peiyu-xie/ucla-209-cache-bist/pcb/Group_12_v2.kicad_pcb

## KiCad design pcb/Group_12_v2.kicad_pcb (2026-10-20)

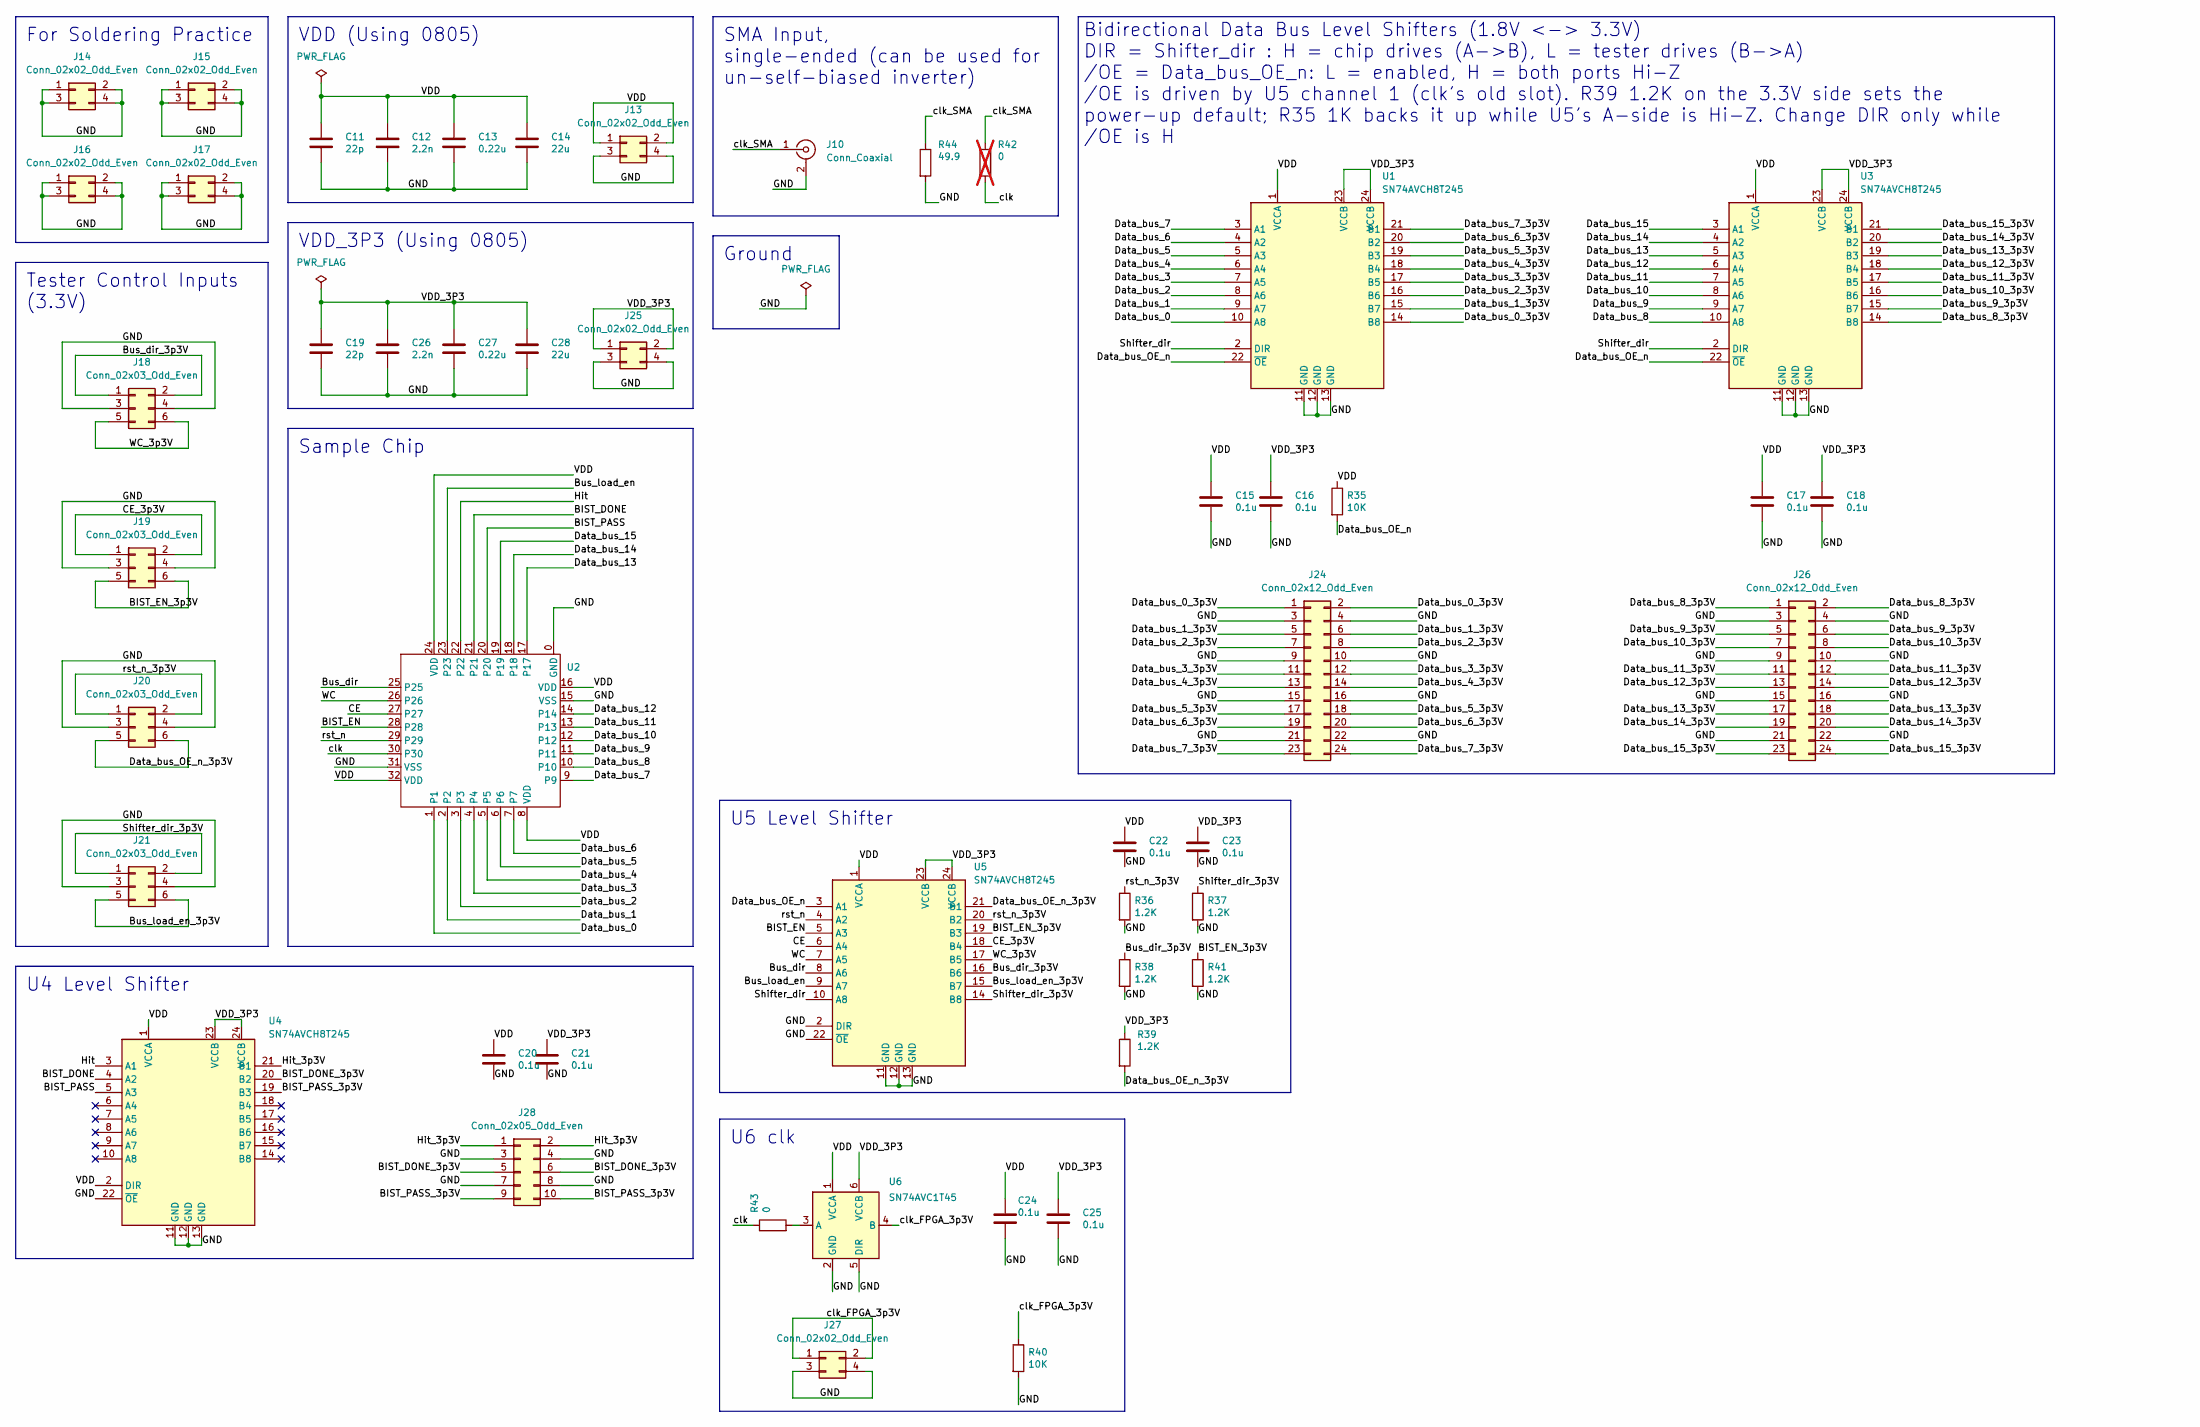
[picture p1: schematic Group_12_v2.kicad_sch]

Parts:
C11, C19: 22p; C_0805_2012Metric_Pad1.18x1.45mm_HandSolder; LCSC Part # C1804
C12, C26: 2.2n; C_0805_2012Metric_Pad1.18x1.45mm_HandSolder; LCSC Part # C28260
C13, C27: 0.22u; C_0805_2012Metric_Pad1.18x1.45mm_HandSolder; LCSC Part # C5378
C14, C28: 22u; C_0805_2012Metric_Pad1.18x1.45mm_HandSolder; LCSC Part # C45783
C15, C16, C17, C18, C20, C21, C22, C23, C24, C25: 0.1u; C_0805_2012Metric_Pad1.18x1.45mm_HandSolder; LCSC Part # C1711
J10: Conn_Coaxial; SMA_Samtec_SMA-J-P-H-ST-EM1_EdgeMount
J13, J14, J15, J16, J17, J25, J27: Conn_02x02_Odd_Even; PinHeader_2x02_P2.54mm_Vertical
J18, J19, J20, J21: Conn_02x03_Odd_Even; PinHeader_2x03_P2.54mm_Vertical
J24, J26: Conn_02x12_Odd_Even; PinHeader_2x12_P2.54mm_Vertical
J28: Conn_02x05_Odd_Even; PinHeader_2x05_P2.54mm_Vertical
R35, R40: 10K; R_0805_2012Metric_Pad1.20x1.40mm_HandSolder; LCSC Part # C17414
R36, R37, R38, R39, R41: 1.2K; R_0805_2012Metric_Pad1.20x1.40mm_HandSolder; LCSC Part # C17379
R42: 0; R_0805_2012Metric_Pad1.20x1.40mm_HandSolder; LCSC Part # C17477; not fitted
R43: 0; R_0805_2012Metric_Pad1.20x1.40mm_HandSolder; LCSC Part # C17477
R44: 49.9; R_0805_2012Metric_Pad1.20x1.40mm_HandSolder; LCSC Part # C17720
U1, U3, U4, U5: SN74AVCH8T245; TSSOP-24_4.4x7.8mm_P0.65mm; LCSC Part # C2652945
U2: EE209AS_2026
U6: SN74AVC1T45; SOT-23-6; LCSC Part # C131978

Connections:
/BIST_DONE: U2.21, U4.4 (A2)
/BIST_DONE_3p3V: J28.5, J28.6, U4.20 (B2)
/BIST_EN: U2.28, U5.5 (A3)
/BIST_EN_3p3V: J19.5, J19.6, R41.1, U5.19 (B3)
/BIST_PASS: U2.20, U4.5 (A3)
/BIST_PASS_3p3V: J28.9, J28.10, U4.19 (B3)
/Bus_dir: U2.25, U5.8 (A6)
/Bus_dir_3p3V: J18.1, J18.2, R38.1, U5.16 (B6)
/Bus_load_en: U2.23, U5.9 (A7)
/Bus_load_en_3p3V: J21.5, J21.6, U5.15 (B7)
/CE: U2.27, U5.6 (A4)
/CE_3p3V: J19.1, J19.2, U5.18 (B4)
/Data_bus_0: U1.10 (A8), U2.1
/Data_bus_0_3p3V: J24.1, J24.2, U1.14 (B8)
/Data_bus_1: U1.9 (A7), U2.2
/Data_bus_1_3p3V: J24.5, J24.6, U1.15 (B7)
/Data_bus_2: U1.8 (A6), U2.3
/Data_bus_2_3p3V: J24.7, J24.8, U1.16 (B6)
/Data_bus_3: U1.7 (A5), U2.4
/Data_bus_3_3p3V: J24.11, J24.12, U1.17 (B5)
/Data_bus_4: U1.6 (A4), U2.5
/Data_bus_4_3p3V: J24.13, J24.14, U1.18 (B4)
/Data_bus_5: U1.5 (A3), U2.6
/Data_bus_5_3p3V: J24.17, J24.18, U1.19 (B3)
/Data_bus_6: U1.4 (A2), U2.7
/Data_bus_6_3p3V: J24.19, J24.20, U1.20 (B2)
/Data_bus_7: U1.3 (A1), U2.9
/Data_bus_7_3p3V: J24.23, J24.24, U1.21 (B1)
/Data_bus_8: U2.10, U3.10 (A8)
/Data_bus_8_3p3V: J26.1, J26.2, U3.14 (B8)
/Data_bus_9: U2.11, U3.9 (A7)
/Data_bus_9_3p3V: J26.5, J26.6, U3.15 (B7)
/Data_bus_10: U2.12, U3.8 (A6)
/Data_bus_10_3p3V: J26.7, J26.8, U3.16 (B6)
/Data_bus_11: U2.13, U3.7 (A5)
/Data_bus_11_3p3V: J26.11, J26.12, U3.17 (B5)
/Data_bus_12: U2.14, U3.6 (A4)
/Data_bus_12_3p3V: J26.13, J26.14, U3.18 (B4)
/Data_bus_13: U2.17, U3.5 (A3)
/Data_bus_13_3p3V: J26.17, J26.18, U3.19 (B3)
/Data_bus_14: U2.18, U3.4 (A2)
/Data_bus_14_3p3V: J26.19, J26.20, U3.20 (B2)
/Data_bus_15: U2.19, U3.3 (A1)
/Data_bus_15_3p3V: J26.23, J26.24, U3.21 (B1)
/Data_bus_OE_n: R35.2, U1.22 (~OE), U3.22 (~OE), U5.3 (A1)
/Data_bus_OE_n_3p3V: J20.5, J20.6, R39.2, U5.21 (B1)
/GND: C11.2, C12.2, C13.2, C14.2, C15.2, C16.2, C17.2, C18.2, C19.2, C20.2, C21.2, C22.2, C23.2, C24.2, C25.2, C26.2, C27.2, C28.2, J10.2 (Ext), J13.3, J13.4, J14.1, J14.2, J14.3, J14.4, J15.1, J15.2, J15.3, J15.4, J16.1, J16.2, J16.3, J16.4, J17.1, J17.2, J17.3, J17.4, J18.3, J18.4, J19.3, J19.4, J20.3, J20.4, J21.3, J21.4, J24.3, J24.4, J24.9, J24.10, J24.15, J24.16, J24.21, J24.22, J25.3, J25.4, J26.3, J26.4, J26.9, J26.10, J26.15, J26.16, J26.21, J26.22, J27.3, J27.4, J28.3, J28.4, J28.7, J28.8, R36.2, R37.2, R38.2, R40.2, R41.2, R44.2, U1.11 (GND), U1.12 (GND), U1.13 (GND), U2.0 (GND), U2.15 (VSS), U2.31 (VSS), U3.11 (GND), U3.12 (GND), U3.13 (GND), U4.11 (GND), U4.12 (GND), U4.13 (GND), U4.22 (~OE), U5.2 (DIR), U5.11 (GND), U5.12 (GND), U5.13 (GND), U5.22 (~OE), U6.2 (GND), U6.5 (DIR)
/Hit: U2.22, U4.3 (A1)
/Hit_3p3V: J28.1, J28.2, U4.21 (B1)
/Shifter_dir: U1.2 (DIR), U3.2 (DIR), U5.10 (A8)
/Shifter_dir_3p3V: J21.1, J21.2, R37.1, U5.14 (B8)
/VDD: C11.1, C12.1, C13.1, C14.1, C15.1, C17.1, C20.1, C22.1, C24.1, J13.1, J13.2, R35.1, U1.1 (VCCA), U2.8 (VDD), U2.16 (VDD), U2.24 (VDD), U2.32 (VDD), U3.1 (VCCA), U4.1 (VCCA), U4.2 (DIR), U5.1 (VCCA), U6.1 (VCCA)
/VDD_3P3: C16.1, C18.1, C19.1, C21.1, C23.1, C25.1, C26.1, C27.1, C28.1, J25.1, J25.2, R39.1, U1.23 (VCCB), U1.24 (VCCB), U3.23 (VCCB), U3.24 (VCCB), U4.23 (VCCB), U4.24 (VCCB), U5.23 (VCCB), U5.24 (VCCB), U6.6 (VCCB)
/WC: U2.26, U5.7 (A5)
/WC_3p3V: J18.5, J18.6, U5.17 (B5)
/clk: R42.2, R43.1, U2.30
/clk_FPGA_3p3V: J27.1, J27.2, R40.1, U6.4 (B)
/clk_SMA: J10.1 (In), R42.1, R44.1
/rst_n: U2.29, U5.4 (A2)
/rst_n_3p3V: J20.1, J20.2, R36.1, U5.20 (B2)
unnamed: R43.2, U6.3 (A)

Notes on the sheet:
VDD_3P3 (Using 0805)
VDD (Using 0805)
SMA Input, single-ended (can be used for un-self-biased inverter)
For Soldering Practice
Ground
Sample Chip
U6 clk
U4 Level Shifter
Tester Control Inputs (3.3V)
U5 Level Shifter
Bidirectional Data Bus Level Shifters (1.8V <-> 3.3V) DIR = Shifter_dir : H = chip drives (A->B), L = tester drives (B->A) /OE = Data_bus_OE_n: L = enabled, H = both ports Hi-Z /OE is driven by U5 channel 1 (clk's old slot). R39 1.2K on the 3.3V side sets the power-up default; R35 1K backs it up wh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

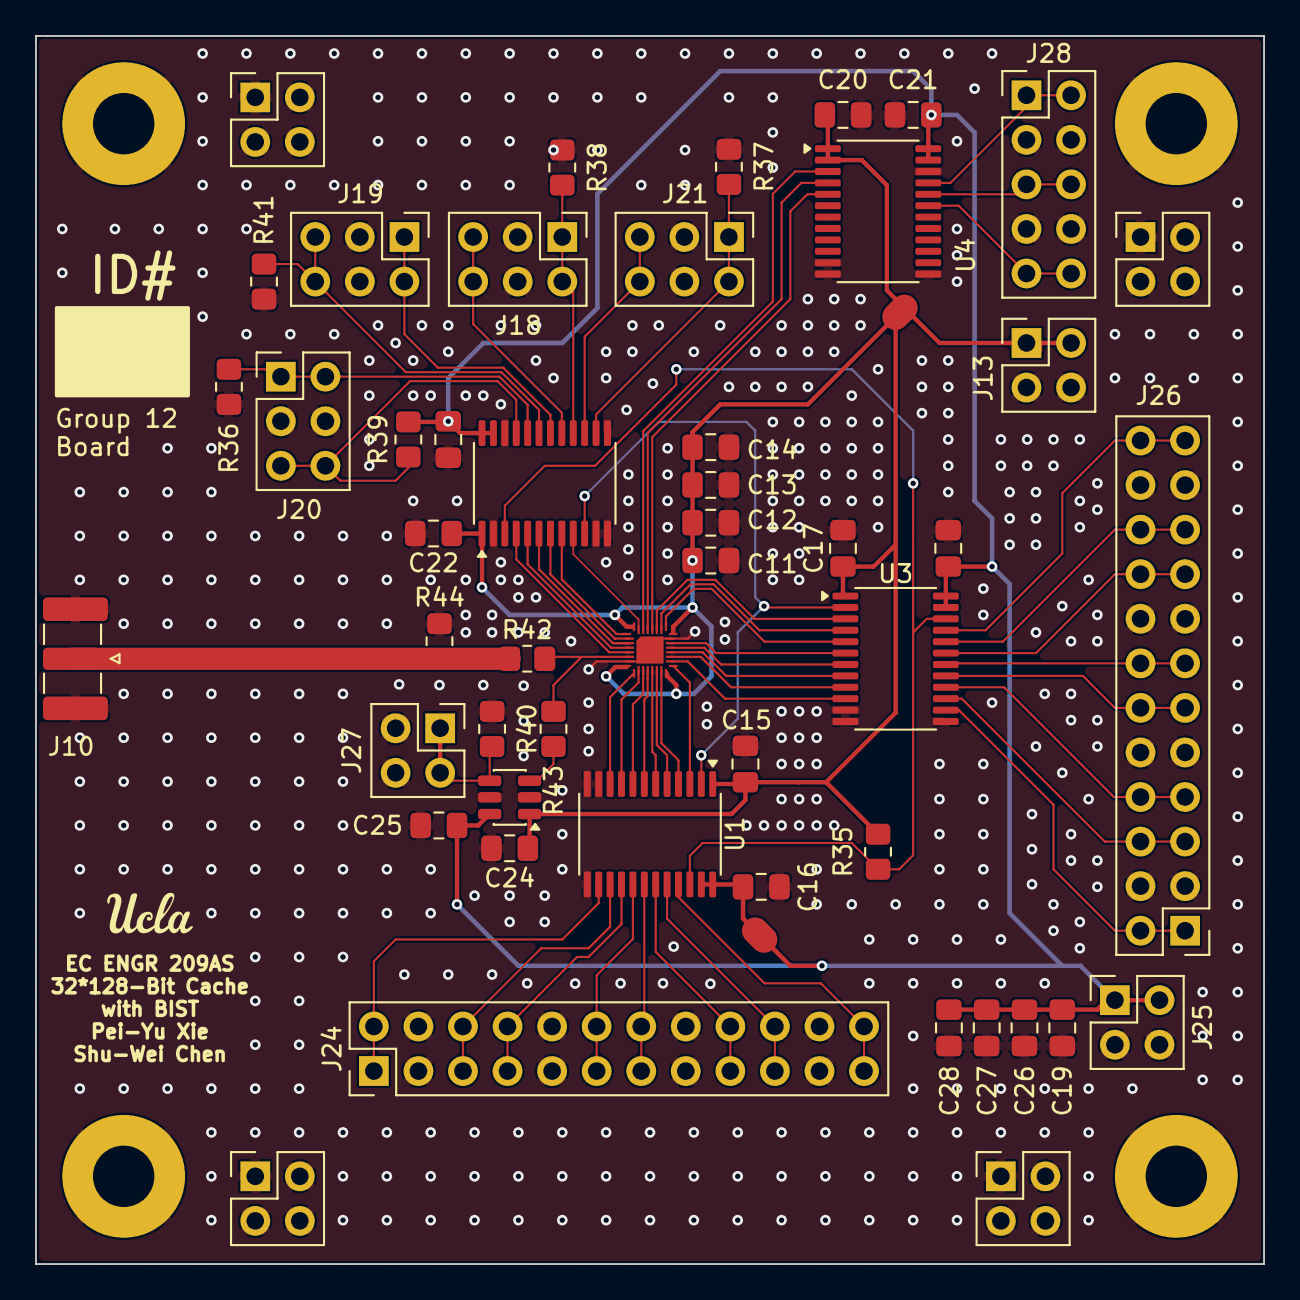
[picture p2: board Group_12_v2.kicad_pcb from above]

Board: 2 copper layers, 70.0 x 70.0 mm, 49 parts (0 on the bottom side), 61 nets.
