peiyu-xie/ucla-209-cache-bist/(commit log)

2026-10-20 Add FPGA tester, test PCB, and MISR; rewrite README
    - rtl/MISR.sv: the 129-bit signature register was missing from the BIST RTL
    - tester/: Zynq (PYNQ-Z2) chip tester -- bus-sequencer FSM in the DUT clock
    domain, MMCM/BUFGMUX/ODDR clocking, register map, test procedure, XDC, build Tcl
    - pcb/: KiCad chip carrier board with level shifters
    - README: document the chip, verification, implementation flow, tester and PCB
2026-10-20 Remove test PCB (designed by project partner)
